Shya-Bubu/Discrete-Logic-Line-Follower/(list of files, drawings)

Other design files:
simulation/Sonic_Logic_Simulation_V3.pdsprj
