Shya-Bubu/Discrete-Logic-Line-Follower/(commit log)

2026-10-23 Update repo: add Proteus simulation file, organize hardware gallery, specify 3-sensor wiring, remove P1 mentions
    [Sonic_Logic_Simulation_V3.pdsprj]
2026-10-23 Add competition demo GIF and update prototype references to V5
